larsch/lasercut-box-openscad/examples/lipbox.png

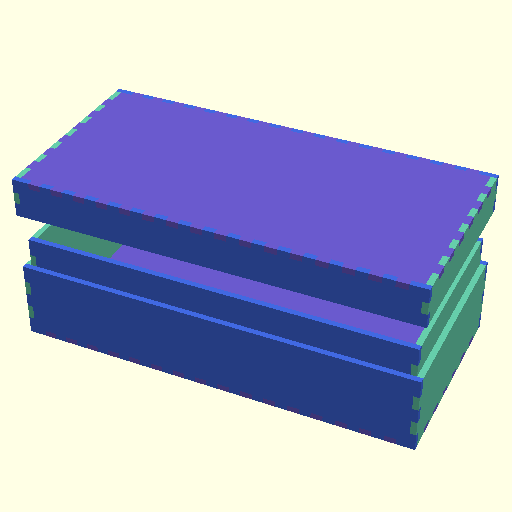
examples/lipbox.png
