larsch/lasercut-box-openscad/examples/pivotbox_bottom.png

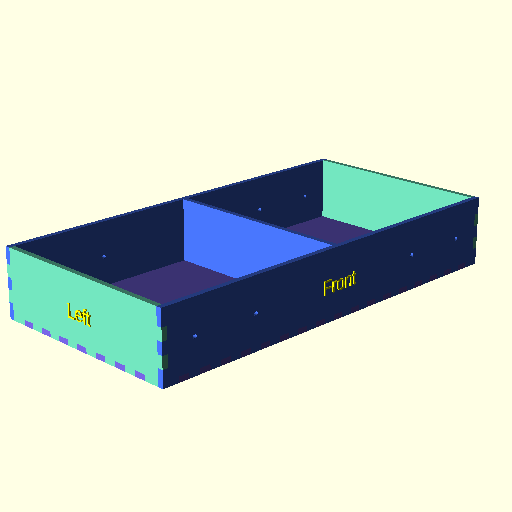
examples/pivotbox_bottom.png
