larsch/lasercut-box-openscad/examples/pivotbox_middle.png

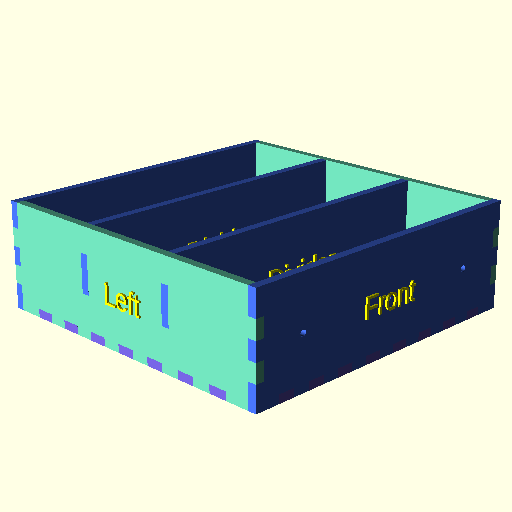
examples/pivotbox_middle.png
