larsch/lasercut-box-openscad/examples/pivotbox_rods.png

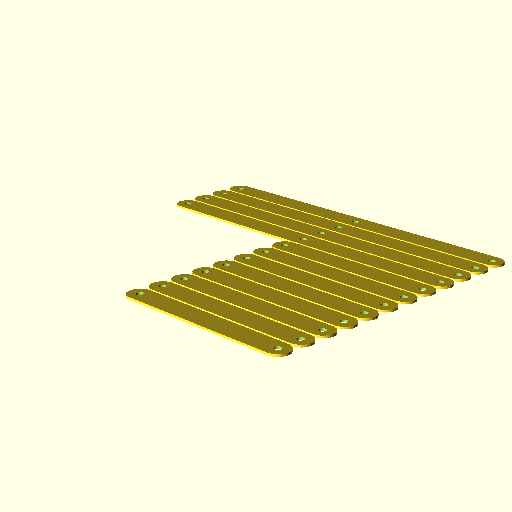
examples/pivotbox_rods.png
