larsch/lasercut-box-openscad/examples/box_hinged_lid_dividers_exploded.scad

include <../box.scad>
box(width = 90, height = 50, depth = 90, dividers = [ 2, 0 ], ears = 10, thickness = 4, open = false, assemble = true, labels = true, explode = 5);
