larsch/lasercut-box-openscad/examples/box_normal.scad

include <../box.scad>
box(width = 120, height = 100, depth = 140, thickness = 4, assemble = true, labels = true);
