larsch/lasercut-box-openscad/examples/box_open.scad

include <../box.scad>
box(width = 120, height = 100, depth = 140, thickness = 4, open = true, assemble = true);
