larsch/lasercut-box-openscad/examples/box_open_dividers.scad

include <../box.scad>
box(width = 120, height = 100, depth = 140, dividers = [ 2, 0 ], thickness = 4, open = true, assemble = true, labels = true, explode = 0);
