larsch/lasercut-box-openscad/(list of files, cad)

Other CAD files:
box_normal_cut.scad
box_open_handles.scad
examples/box_animated.scad
examples/box_normal_cut.scad
examples/box_open_handles.scad
examples/box_with_lid.scad
examples/pivotbox_bottom.scad
