larsch/lasercut-box-openscad/(threads)

Thread 3 (2017-08-13):

divider not shown

rkarlsba, 2017-08-13:
I tried to make a simple model with two deviders vertically, and for some reason one of them doesn't show up unless I set deviders=2.00000001 or something. Library was just checked out from github and Openscad is version 2015.03-3. Please see attached screenshots.

roy
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

larsch, 2017-08-13:
Fixed. Thanks for reporting.

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

Closed 2017-08-13.

Thread 6 (2019-09-01):

Magazine holder style box

jmankoff, 2019-09-01:
Hi,

I am trying to make a magazine holder for my daughter. I modified your code to include this capability, and attached it here in case this is useful to the repo
[boxmag.scad.gz](https://github.com/larsch/lasercut-box-openscad/files/3563643/boxmag.scad.gz)

sitory.

rkarlsba, 2019-12-28:
Not sure what's happening to this repo, so I've forked it to https://github.com/rkarlsba/lasercut-box-openscad and have brought your version along, patched into mine. It doesn't work, though, or perhaps I've done something wrong, so if you can take a look, it'd be nice.

Thread 10 (2022-01-15):

Dividers are not shortened when inset>0

phildubach, 2022-01-15:
On current master (375f59f7eeaecb6c34361293cd6343d336f5de43):

When using a box with an inset and dividers, the dividers extend into the bottom.
I'm using an open box:
```
TH=2.7; DIA=75; H=90; IN=2;
box(width=DIA*3+4*TH,height=H+TH+IN,depth=DIA*2+3*TH,thickness=TH,
    dividers=[1,2],open=true,assemble=true,spacing=2,inset=IN,kerf=0.1);
```
This works like a charm, except for the dividers. The inset should shorten them
at the bottom. Sadly, I only noticed after the box was already cut.
See picture. The top of the dividers and side are flush, but the bottom of the
dividers overlaps the finger cutouts for the bottom.

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

I'll attempt a fix and send a pull request.
