larsch/lasercut-box-openscad/(commit log)

2016-08-06 First version
    [box.scad]
2016-08-07 First public version
    [box.scad, box_animated.scad, box_normal.scad, box_open.scad, box_open_handles.scad, box_with_lid.scad]
2016-08-07 Add render example
    [box_normal_cut.scad]
2016-08-07 Add kerf compensation option
    [box_open_handles.scad]
2016-08-07 Add kerf compensation to render
    [box_normal_cut.scad, box_open_handles.scad]
2016-08-07 Add labels to example
    [box_normal.scad]
2016-09-01 Add initial support for dividers.
    [box.scad]
2016-09-05 Add support for ears.
    [box.scad]
2016-09-13 Fix ear bugs.
    [box.scad]
2016-10-01 Add support for holes; make w dividers work.
    [box.scad]
2016-10-01 Move examples to examples subdir.
    [box_animated.scad, box_hinged_lid_dividers_exploded.scad, box_normal.scad, box_normal_cut.scad, box_open.scad, box_open_dividers.scad, box_open_handles.scad, box_with_lid.scad]
2016-10-01 Add pivotbox.
    [pivotbox.scad, pivotbox_bottom.scad, pivotbox_defs.scad, pivotbox_middle.scad, pivotbox_top.scad]
2016-10-01 Make hole diameter a parameter.
    [box.scad, pivotbox_bottom.scad, pivotbox_defs.scad, pivotbox_middle.scad, pivotbox_top.scad]
2016-10-01 Add rods.
    [pivotbox_defs.scad, pivotbox_rods.scad]
2016-12-29 Added color for w and h dividers.
    [box.scad]
2016-12-29 Added cuts to make dividers cross.
    [box.scad]
2017-01-03 Fix kerf messup
    [box.scad]
2017-01-04 Update box.scad
    add +kerf here to allow delimiters to be layed out correctly
    [box.scad]
2017-03-25 Add spacing parameter
    Add spacing parameter to allow gaps between parts. The default settings makes it too hard to move parts around in programs like Inkspace. The default setting remain as before, but the new parameter allows for adding spacing.
    [box.scad]
2017-04-06 Option to use inner dimensions instead of outer
    [box.scad]
2017-08-13 Fix rounding issues when making dividers
    Dividers were iterated using floating points causing the script to miss
    the last divider and cut in some cases, included in the 2D render.
    Closes #3.
    [box.scad]
2017-08-13 Make explode option push divider out of box
    [box.scad]
2017-08-13 Remove tabs
    [box.scad]
2019-01-24 Fix box_with_lid example panels overlapping
    [box_with_lid.scad]
2020-07-16 Add support for box with open bottom
    [box.scad]
2020-07-16 Add example of box with lid and inner lip
    [lipbox.scad]
2020-07-16 Remove unused parameters
    [box.scad]
2023-03-17 Check that ears parameter is valid.
    [box.scad, pivotbox_top.scad]
2023-04-15 Use correct inner dimensions when open
    When using inner=true, the dimensions would be incorrect when the top or
    bottom was open.
    [box.scad, lipbox.scad]
